DhimanSarkar-NCSM-Exhibits/Robotic-Arm/other_files/documentation/assets/assembly/mount1_assembly.jpg

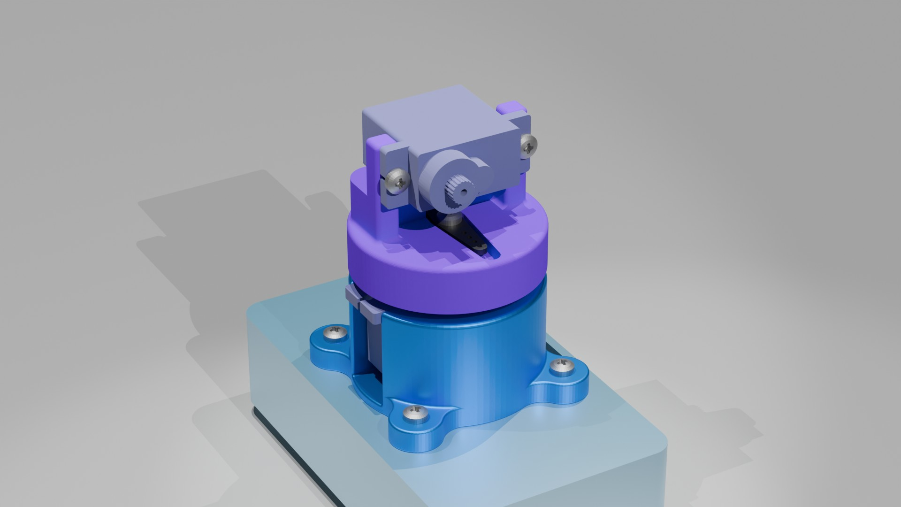
other_files/documentation/assets/assembly/mount1_assembly.jpg
