DhimanSarkar-NCSM-Exhibits/Robotic-Arm/other_files/documentation/assets/assembly/whole_assemblyl.jpg

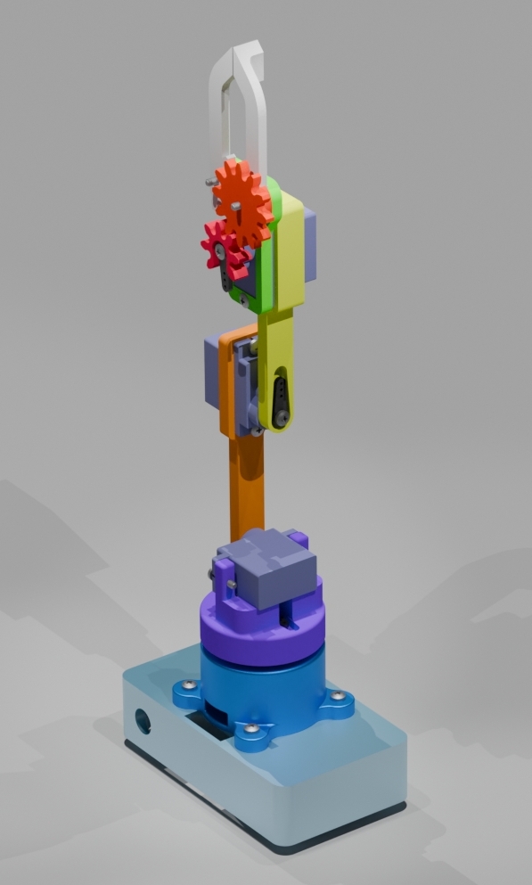
other_files/documentation/assets/assembly/whole_assemblyl.jpg
