DhimanSarkar-NCSM-Exhibits/Robotic-Arm/README.md

# Documentation

see documentation [here](Information%20Brochure).

# Presentation Link

[https://dhimansarkar-ncsm.my.canva.site/nscd-summer-camp-2026-robotics-workshop](https://dhimansarkar-ncsm.my.canva.site/nscd-summer-camp-2026-robotics-workshop)
