DhimanSarkar-NCSM-Exhibits/Robotic-Arm/other_files/documentation/assets/22_screw_heads.jpg

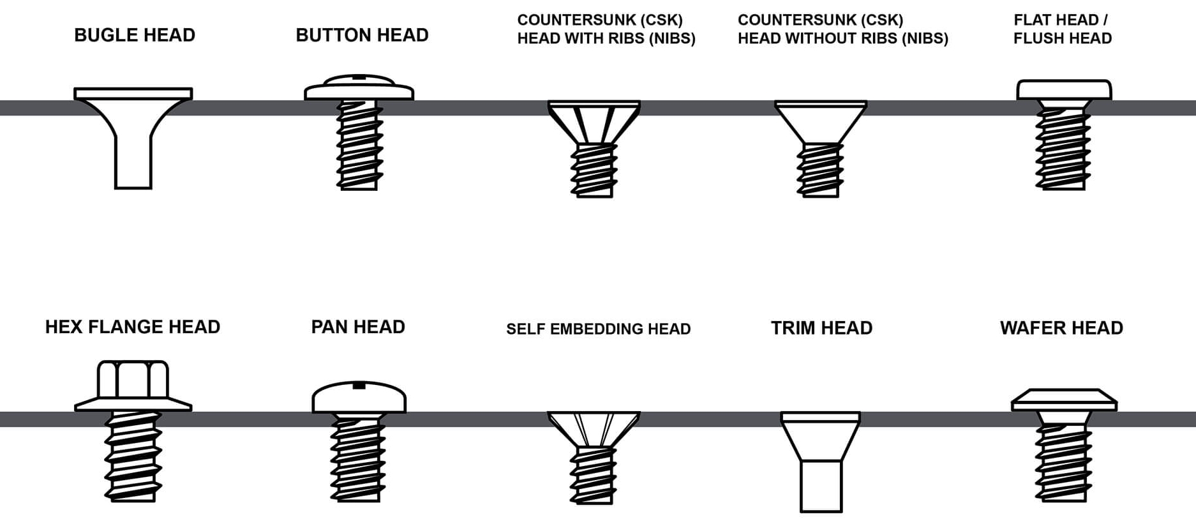
other_files/documentation/assets/22_screw_heads.jpg
