DhimanSarkar-NCSM-Exhibits/Robotic-Arm/other_files/documentation/assets/28_PCA9685.jpg

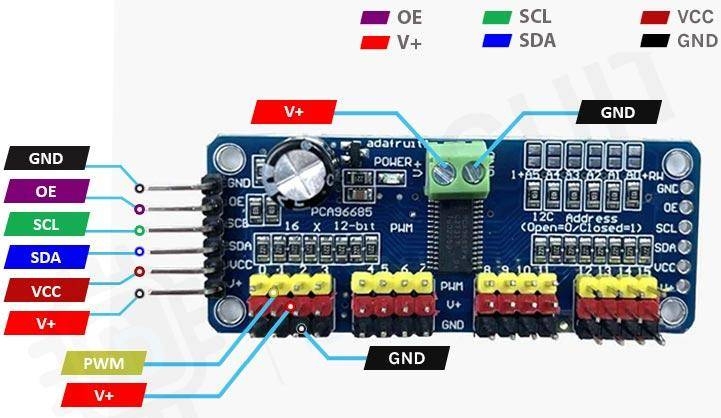
other_files/documentation/assets/28_PCA9685.jpg
