DhimanSarkar-NCSM-Exhibits/Robotic-Arm/other_files/documentation/assets/34_wro.jpg

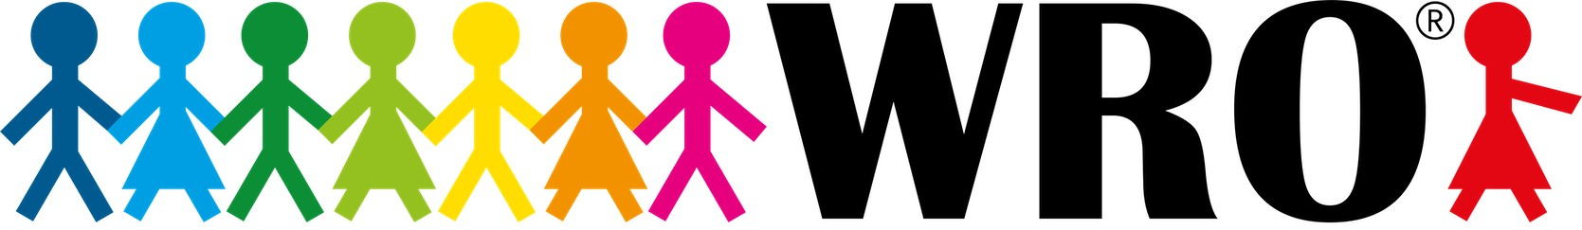
other_files/documentation/assets/34_wro.jpg
