DhimanSarkar-NCSM-Exhibits/Robotic-Arm/other_files/documentation/assets/cover-page-bg.jpg

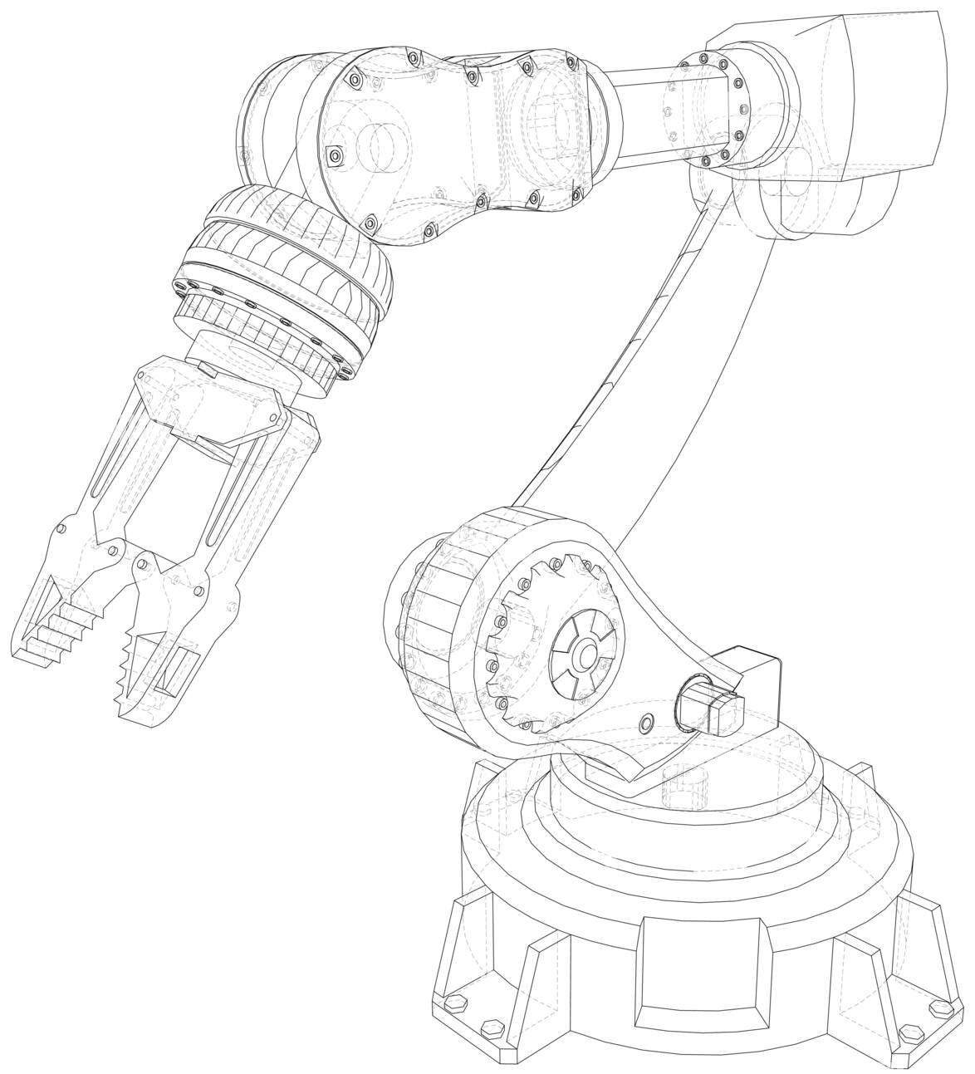
other_files/documentation/assets/cover-page-bg.jpg
