DhimanSarkar-NCSM-Exhibits/Robotic-Arm/other_files/documentation/assets/ide/ide_3.png

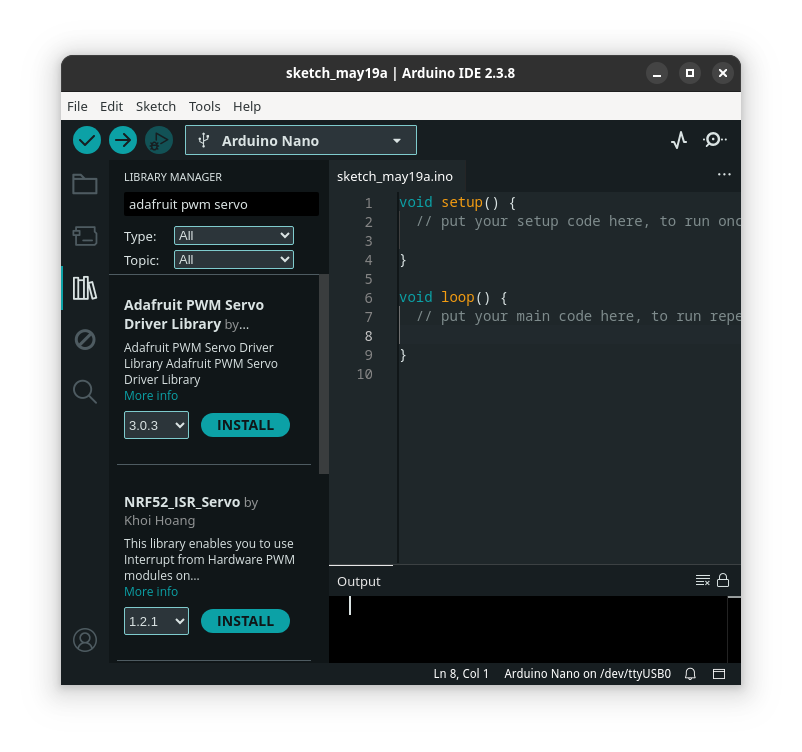
other_files/documentation/assets/ide/ide_3.png
