DhimanSarkar-NCSM-Exhibits/Robotic-Arm/other_files/documentation/assets/ide/ide_4.png

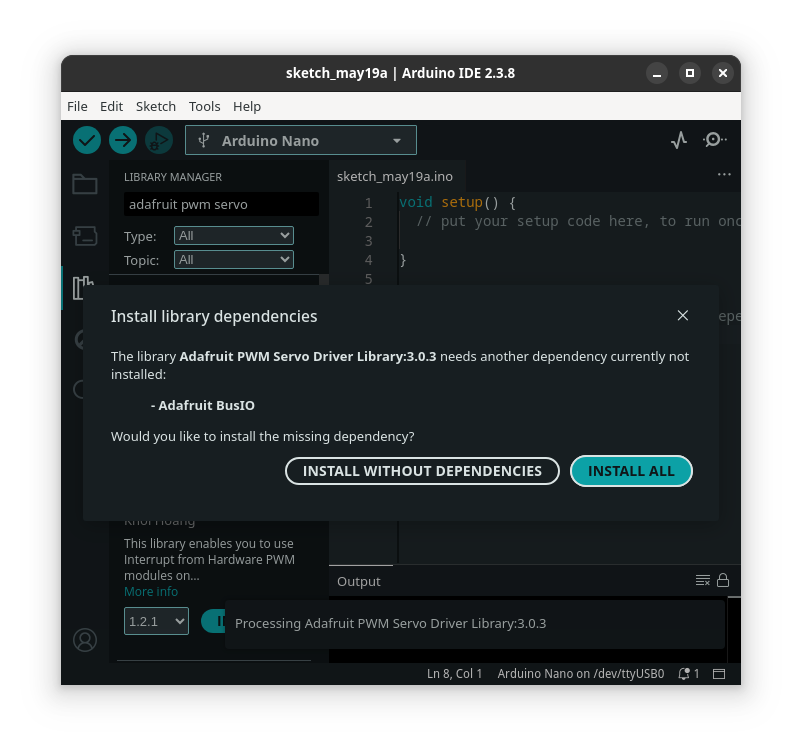
other_files/documentation/assets/ide/ide_4.png
