DhimanSarkar-NCSM-Exhibits/Robotic-Arm/other_files/documentation/assets/ide/ide_6.png

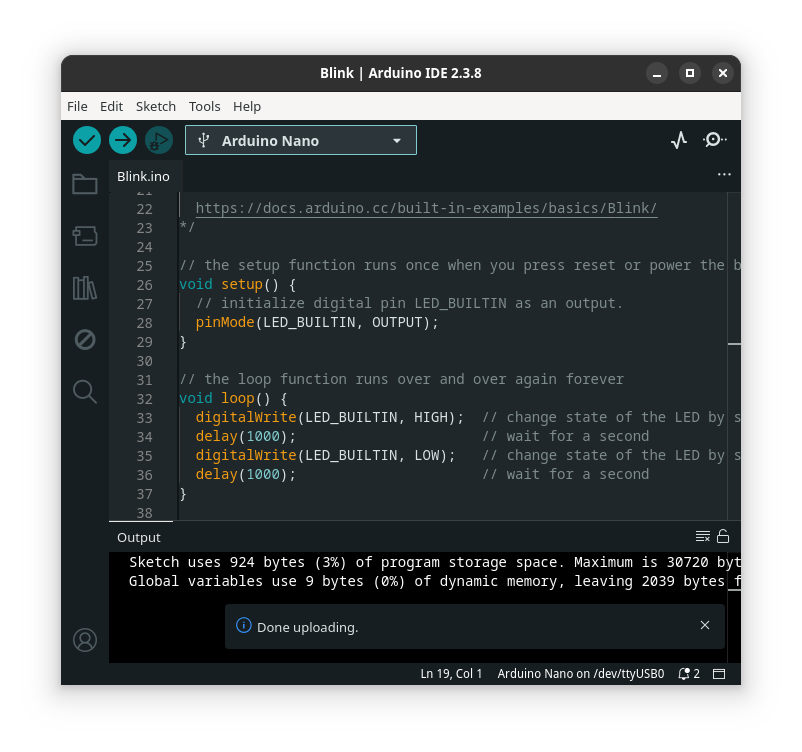
other_files/documentation/assets/ide/ide_6.png
