DhimanSarkar-NCSM-Exhibits/Robotic-Arm/other_files/documentation/assets/08_robot_component.jpg

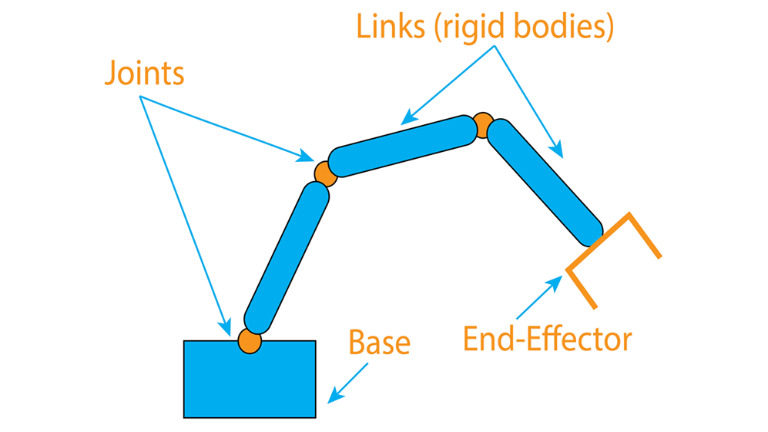
other_files/documentation/assets/08_robot_component.jpg
