DhimanSarkar-NCSM-Exhibits/Robotic-Arm/other_files/mechanical_parts/reference_drawings/fKxgk3c.gif

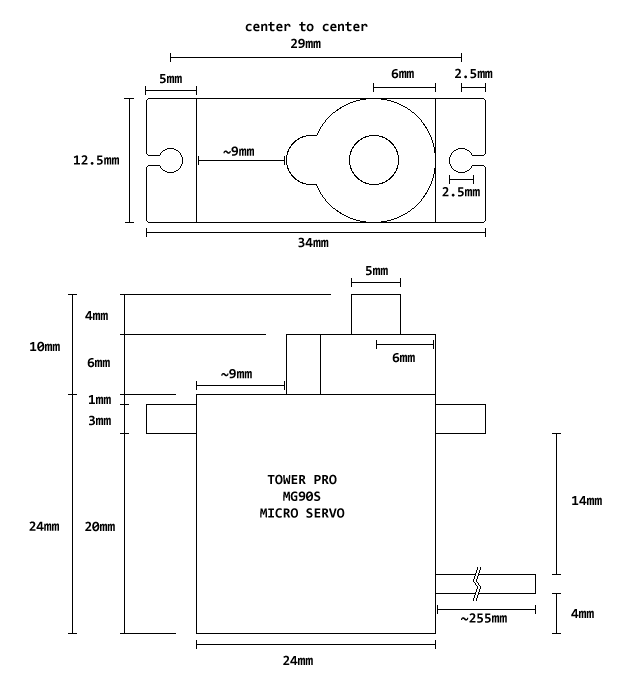
other_files/mechanical_parts/reference_drawings/fKxgk3c.gif
