DhimanSarkar-NCSM-Exhibits/Robotic-Arm/other_files/mechanical_parts/reference_drawings/sg90-servo-horn-drawing.webp

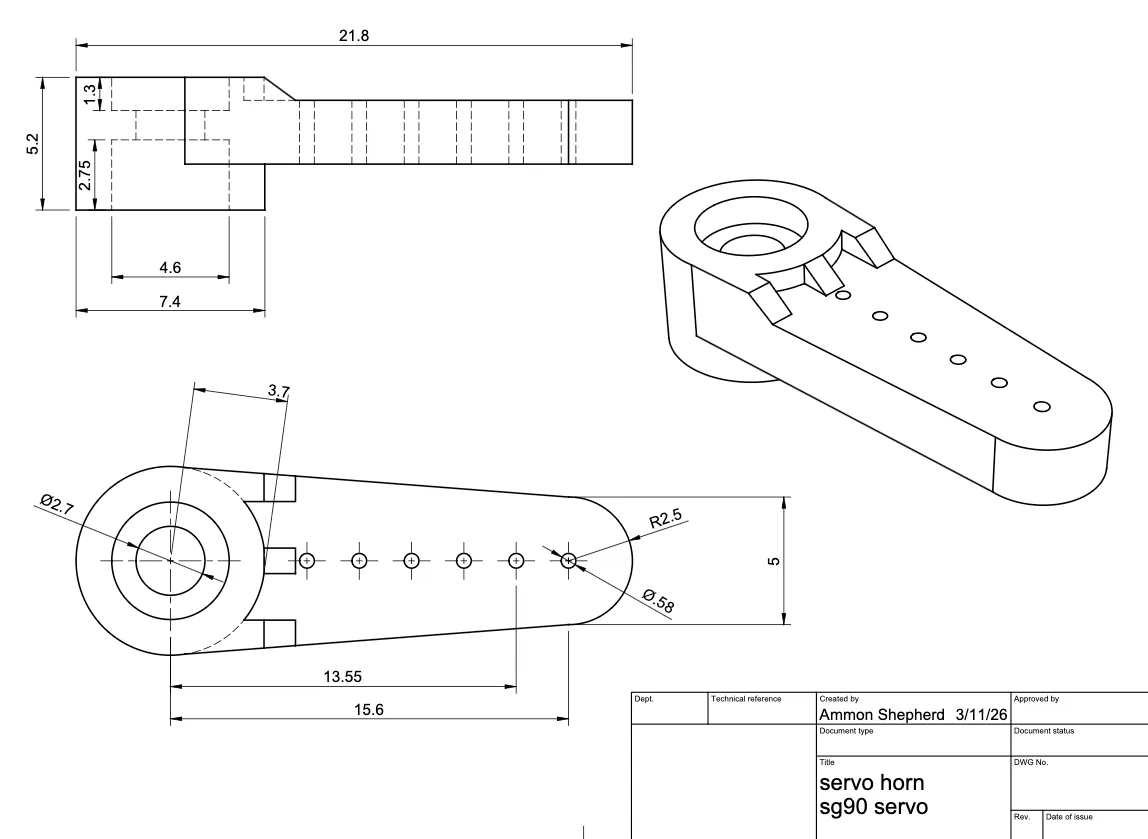
other_files/mechanical_parts/reference_drawings/sg90-servo-horn-drawing.webp
