DhimanSarkar-NCSM-Exhibits/Robotic-Arm/3D CAD Files/gear2.stl

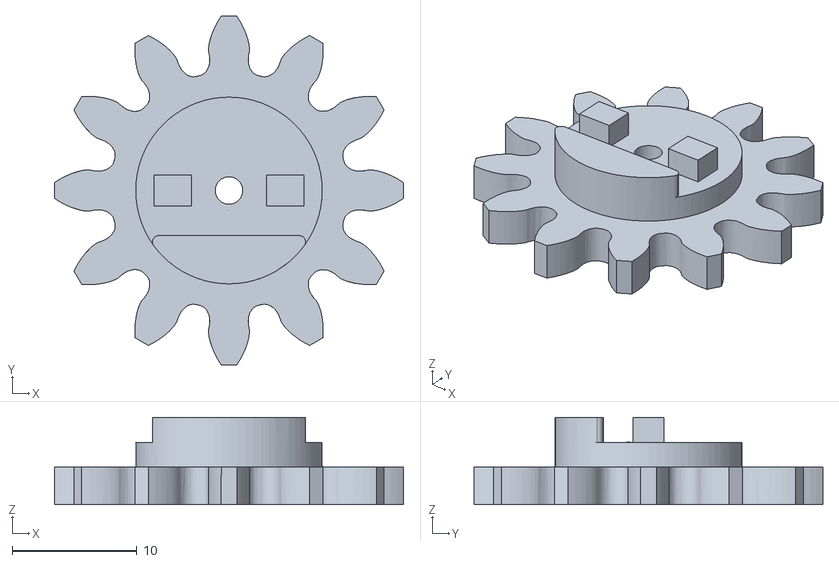
[picture p64: CAD file, 2026-05-29]
3D CAD Files/gear2.stl
28.0 x 28.0 x 7.00
