DhimanSarkar-NCSM-Exhibits/Robotic-Arm/other_files/anim/6g_servo_arm_dual.stl

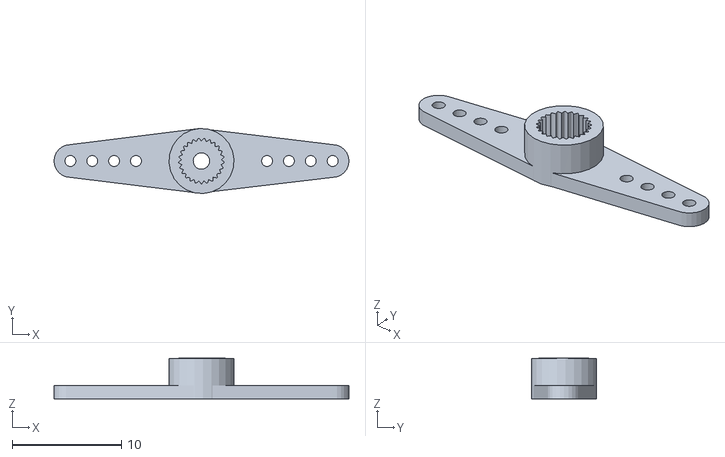
[picture p65: CAD file, 2026-05-15]
other_files/anim/6g_servo_arm_dual.stl
27.0 x 5.95 x 3.71
