DhimanSarkar-NCSM-Exhibits/Robotic-Arm/3D CAD Files/link1.stl

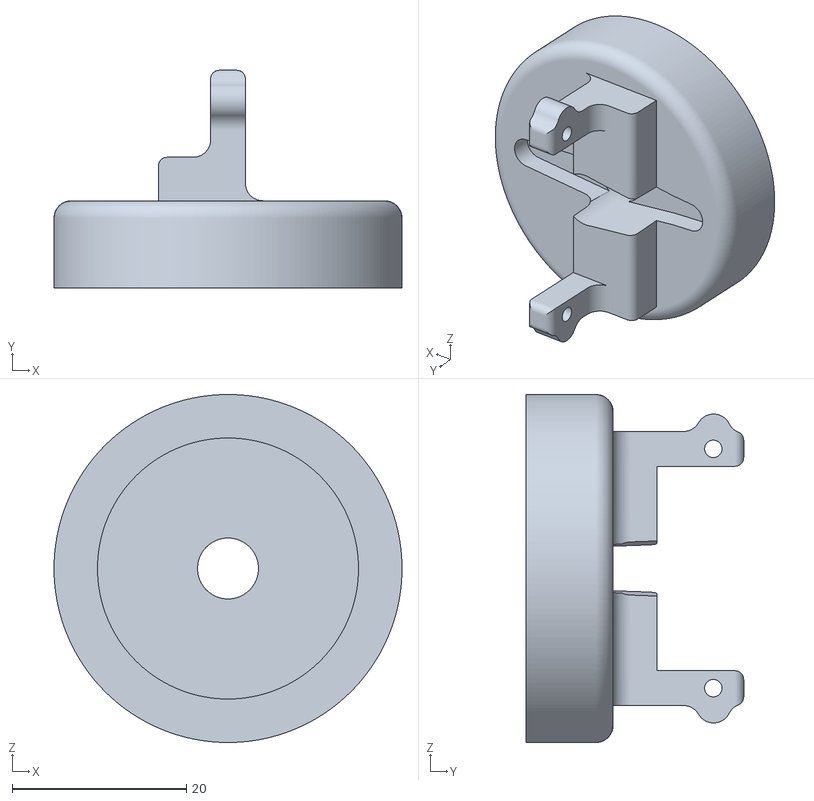
[picture p66: CAD file, 2026-05-28]
3D CAD Files/link1.stl
40.0 x 25.0 x 40.0
