DhimanSarkar-NCSM-Exhibits/Robotic-Arm/3D CAD Files/base1.stl

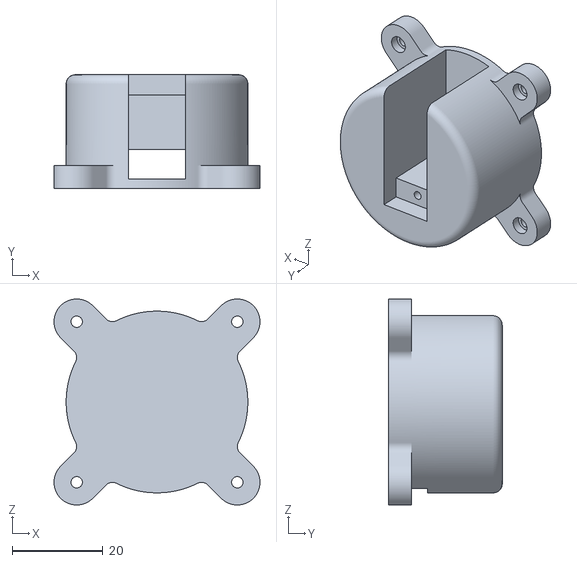
[picture p67: CAD file, 2026-05-22]
3D CAD Files/base1.stl
45.4 x 25.0 x 45.4
