DhimanSarkar-NCSM-Exhibits/Robotic-Arm/other_files/anim/6g_servo_arm_quad.stl

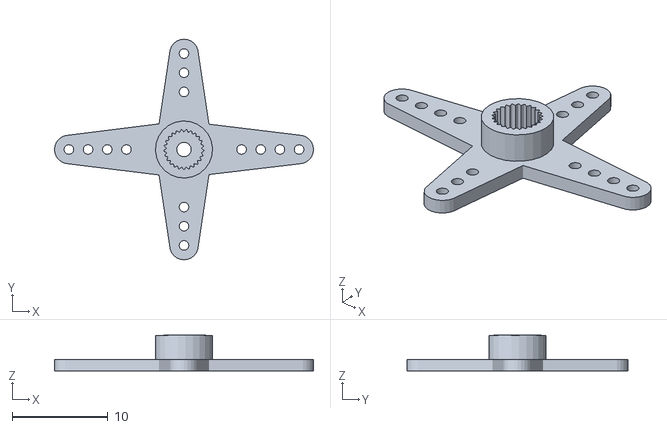
[picture p68: CAD file, 2026-05-15]
other_files/anim/6g_servo_arm_quad.stl
27.0 x 23.0 x 3.71
