DhimanSarkar-NCSM-Exhibits/Robotic-Arm/3D CAD Files/mount1.stl

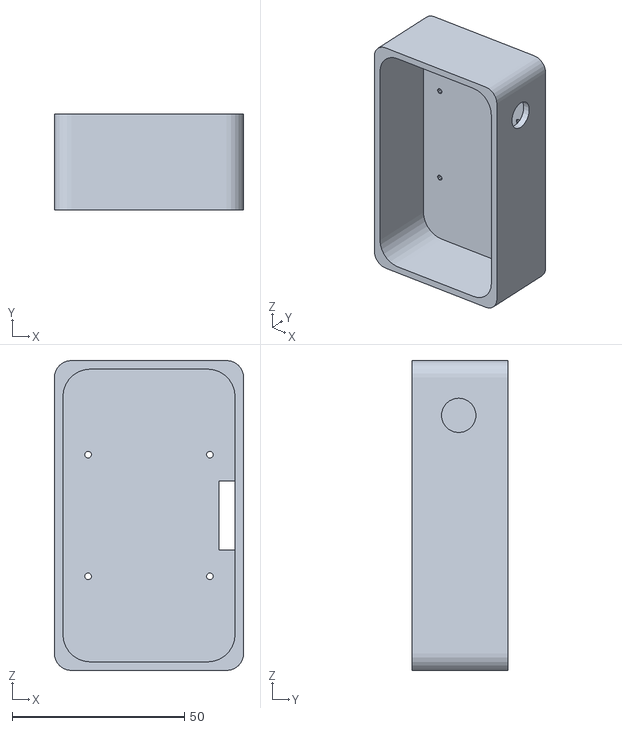
[picture p69: CAD file, 2026-05-20]
3D CAD Files/mount1.stl
55.0 x 28.0 x 90.0
