DhimanSarkar-NCSM-Exhibits/Robotic-Arm/other_files/anim/6g_servo_arm_single.stl

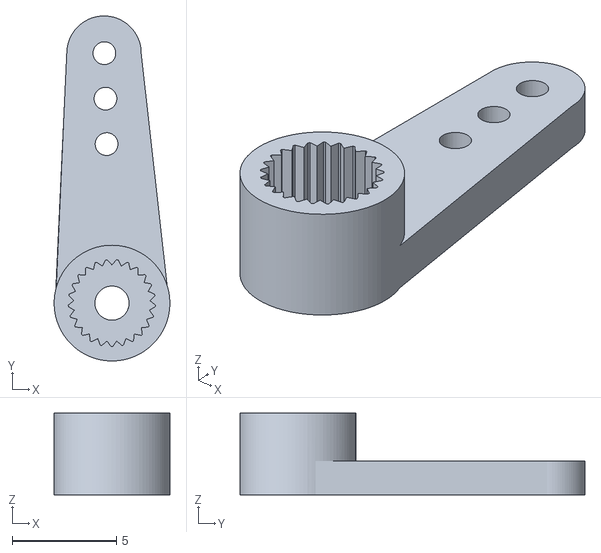
[picture p70: CAD file, 2026-05-15]
other_files/anim/6g_servo_arm_single.stl
5.54 x 16.5 x 3.92
