DhimanSarkar-NCSM-Exhibits/Robotic-Arm/3D CAD Files/end_effector_base.stl

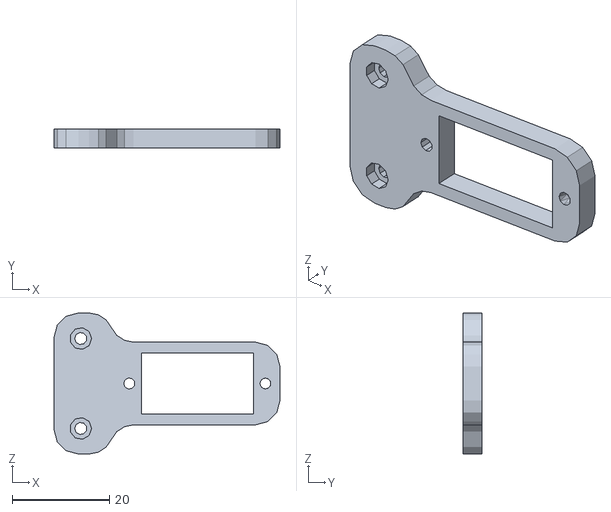
[picture p71: CAD file, 2026-05-20]
3D CAD Files/end_effector_base.stl
46.5 x 4.00 x 29.0
