DhimanSarkar-NCSM-Exhibits/Robotic-Arm/other_files/anim/SG90-Servo.stl

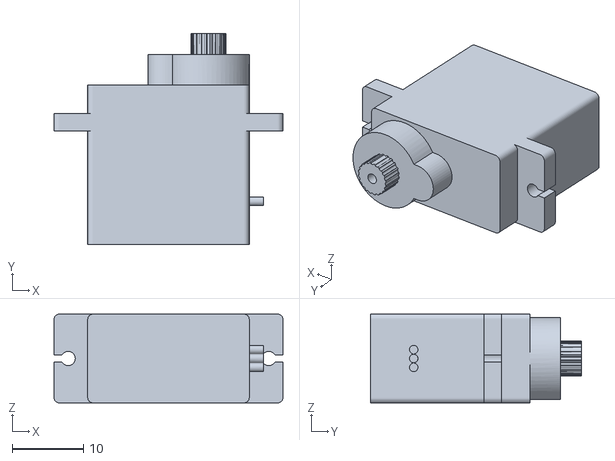
[picture p72: CAD file, 2026-05-15]
other_files/anim/SG90-Servo.stl
32.2 x 29.8 x 12.5
