DhimanSarkar-NCSM-Exhibits/Robotic-Arm/3D CAD Files/link3.stl

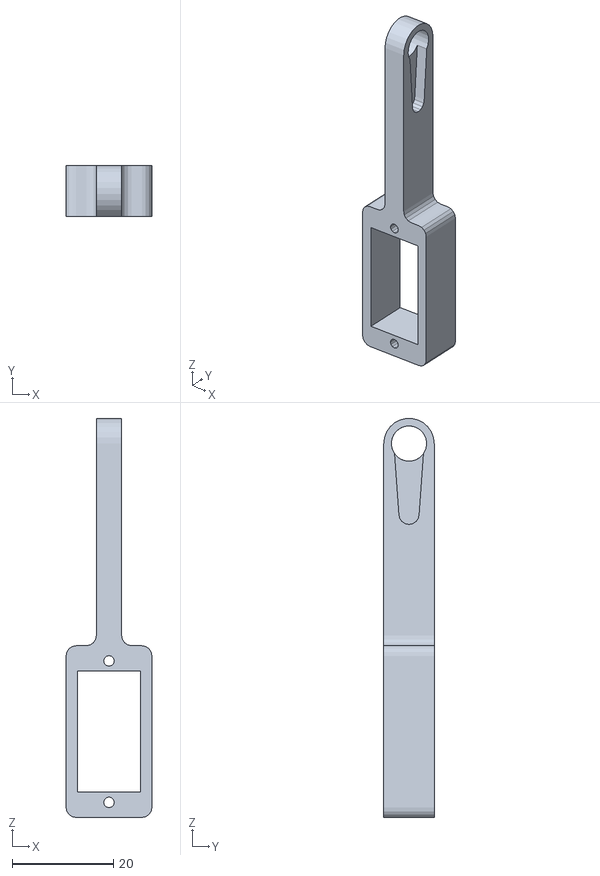
[picture p73: CAD file, 2026-05-20]
3D CAD Files/link3.stl
17.0 x 10.0 x 79.0
