DhimanSarkar-NCSM-Exhibits/Robotic-Arm/other_files/anim/6g_servo_arm_round.stl

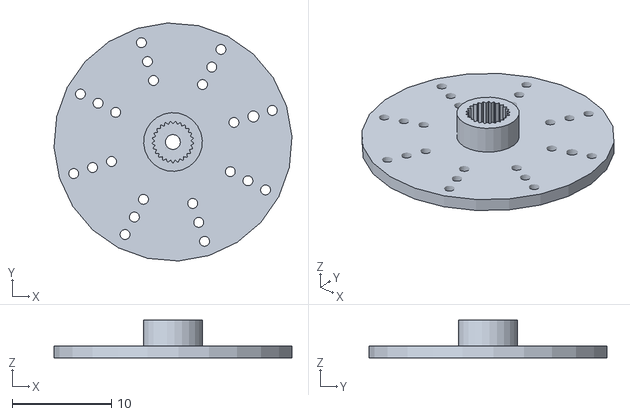
[picture p74: CAD file, 2026-05-15]
other_files/anim/6g_servo_arm_round.stl
24.0 x 24.0 x 3.81
