DhimanSarkar-NCSM-Exhibits/Robotic-Arm/3D CAD Files/link2.stl

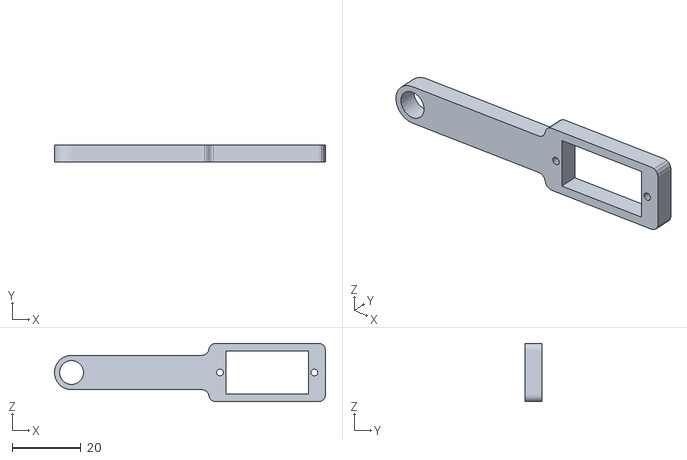
[picture p75: CAD file, 2026-05-19]
3D CAD Files/link2.stl
79.0 x 5.00 x 17.0
