DhimanSarkar-NCSM-Exhibits/Robotic-Arm/other_files/anim/6g_servo_arm_set.stl

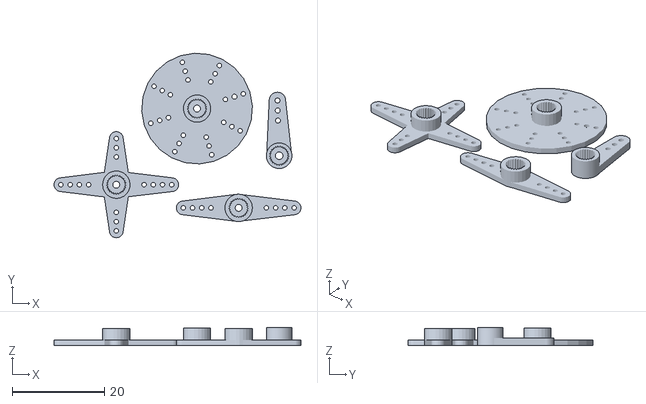
[picture p76: CAD file, 2026-05-15]
other_files/anim/6g_servo_arm_set.stl
53.5 x 40.0 x 3.92
