DhimanSarkar-NCSM-Exhibits/Robotic-Arm/3D CAD Files/gear1.stl

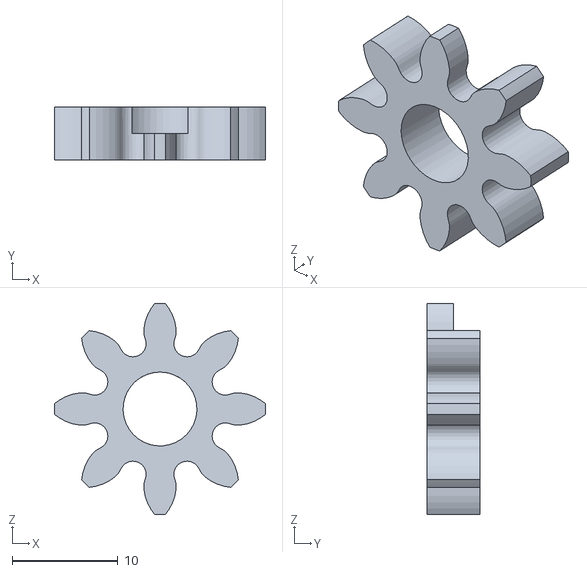
[picture p77: CAD file, 2026-05-18]
3D CAD Files/gear1.stl
20.0 x 5.00 x 20.0
