DhimanSarkar-NCSM-Exhibits/Robotic-Arm/3D CAD Files/end_effector_arm2_m2.stl

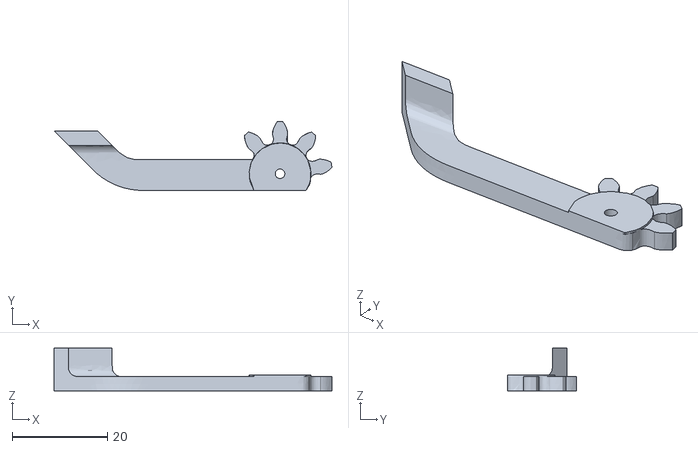
[picture p78: CAD file, 2026-05-15]
3D CAD Files/end_effector_arm2_m2.stl
58.4 x 14.5 x 9.00
