DhimanSarkar-NCSM-Exhibits/Robotic-Arm/other_files/anim/m025x010_pan_phillips_coarse.stl

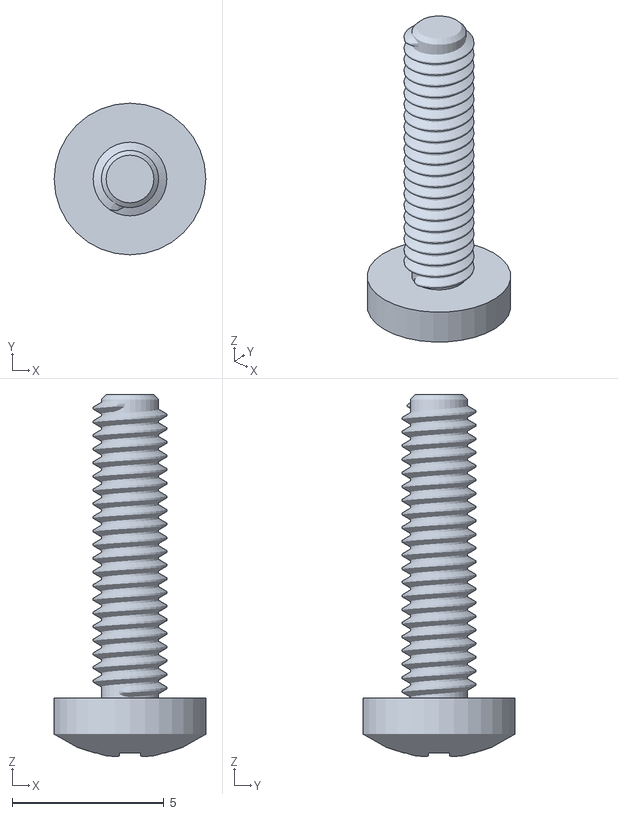
[picture p79: CAD file, 2026-05-15]
other_files/anim/m025x010_pan_phillips_coarse.stl
5.00 x 5.00 x 11.9
