DhimanSarkar-NCSM-Exhibits/Robotic-Arm/(list of files, cad)

Other CAD files:
3D CAD Files/end_effector_arm1_m2.stl
other_files/anim/anim.blend
other_files/anim/video-composite.blend
other_files/mechanical_parts/design_files/base1.ipt
other_files/mechanical_parts/design_files/end_effector_base.ipt
other_files/mechanical_parts/design_files/joint1.ipt
other_files/mechanical_parts/design_files/joint1_stl_import.ipt
other_files/mechanical_parts/design_files/link1.ipt
other_files/mechanical_parts/design_files/link2.ipt
other_files/mechanical_parts/design_files/link3.ipt
other_files/mechanical_parts/design_files/mount1.ipt
