DhimanSarkar-NCSM-Exhibits/Robotic-Arm/other_files/anim/final_assembly.jpg

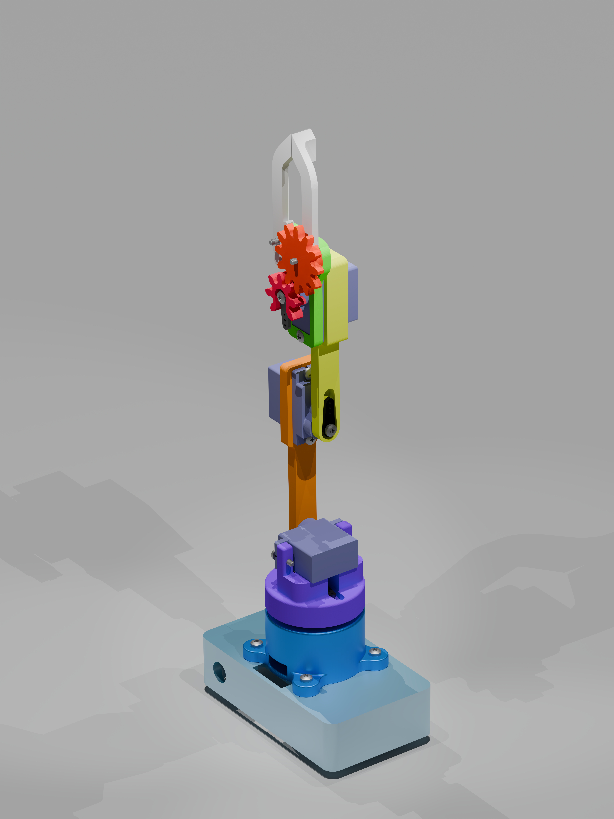
other_files/anim/final_assembly.jpg
