DhimanSarkar-NCSM-Exhibits/Robotic-Arm/other_files/documentation/assets/wiring_sch_bb.pdf

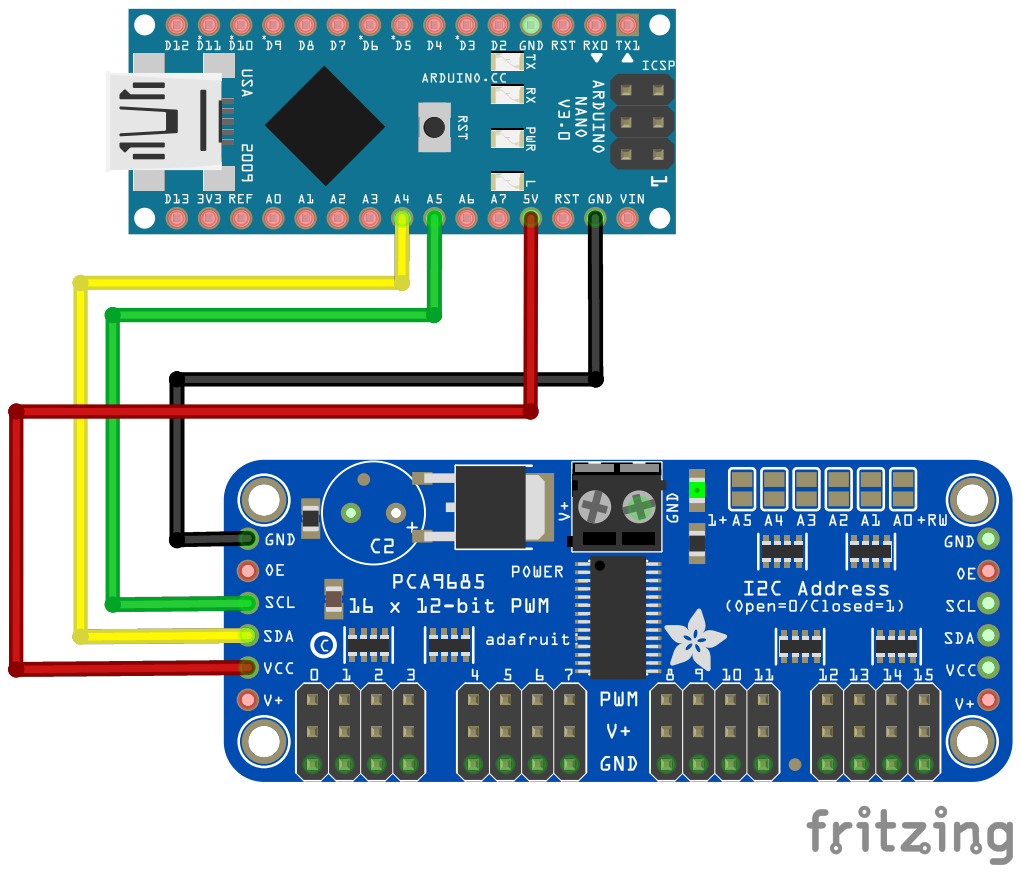
[picture p81: page 1]
