DhimanSarkar-NCSM-Exhibits/Robotic-Arm/(list of files, drawings)

Other design files:
other_files/documentation/assets/wiring_sch.fzz
