DhimanSarkar-NCSM-Exhibits/Robotic-Arm/(commit log)

2026-05-15 Mechanical parts
    [base1.stl, claw_base.stl, end_effector_arm1.stl, end_effector_arm2.stl, gear1.stl, gear2.stl, hand1.stl, hand2.stl]
2026-05-15 anim update link1
    [anim.blend]
2026-05-16 mech link3
    [anim.blend]
2026-05-16 arduino code add
2026-05-16 all added need refinement
    [anim.blend]
2026-05-18 v1.1 init
    [anim.blend]
2026-05-18 mech new
    [gear.stl, gear_arm1.stl, gear_arm2.stl, gear_servo.stl, joint1.0016.ipt, joint1.ipt, joint1.stl, joint1_.0002.ipt]
2026-05-19 new mech
    [base1.0019.ipt, base1.ipt, base1.stl, link1.0040.ipt, link1.0053.ipt, link1.ipt, link1.stl, link2.0014.ipt]
2026-05-20 end effector
    [end_effector_base.stl]
2026-05-20 link1 fix
    [link1.stl]
2026-05-20 base1 fix
    [base1.stl]
2026-05-20 link3 fix
    [link3.stl]
2026-05-20 end effector fix
    [end_effector_base.stl]
2026-05-20 end effector fix, mount
    [end_effector_base.ipt, end_effector_base.stl, mount1.ipt, mount1.stl]
2026-05-20 mech fix
    [anim.blend, arm-1.stl, arm-2.stl, arm_support.stl, base-2.stl, base1.stl, base_breadboard.stl, case.stl]
2026-05-22 base1 mesh high
    [base1.stl]
2026-05-27 gear2 d2.1
    [gear2_d2p1.stl]
2026-05-28 screw support added
    [link1.ipt, link1.stl]
2026-05-29 servo_test sketch
2026-05-29 gear2 dp2p
    [gear2_d2p2.stl]
2026-06-01 refactor folder structure
    [6g_servo_arm_dual.stl, 6g_servo_arm_quad.stl, 6g_servo_arm_round.stl, 6g_servo_arm_set.stl, 6g_servo_arm_single.stl, SG90-Servo.stl, anim.blend, base1.ipt]
